nexx/nxencoder-util/stl/nxencoder_idler_housing.stl

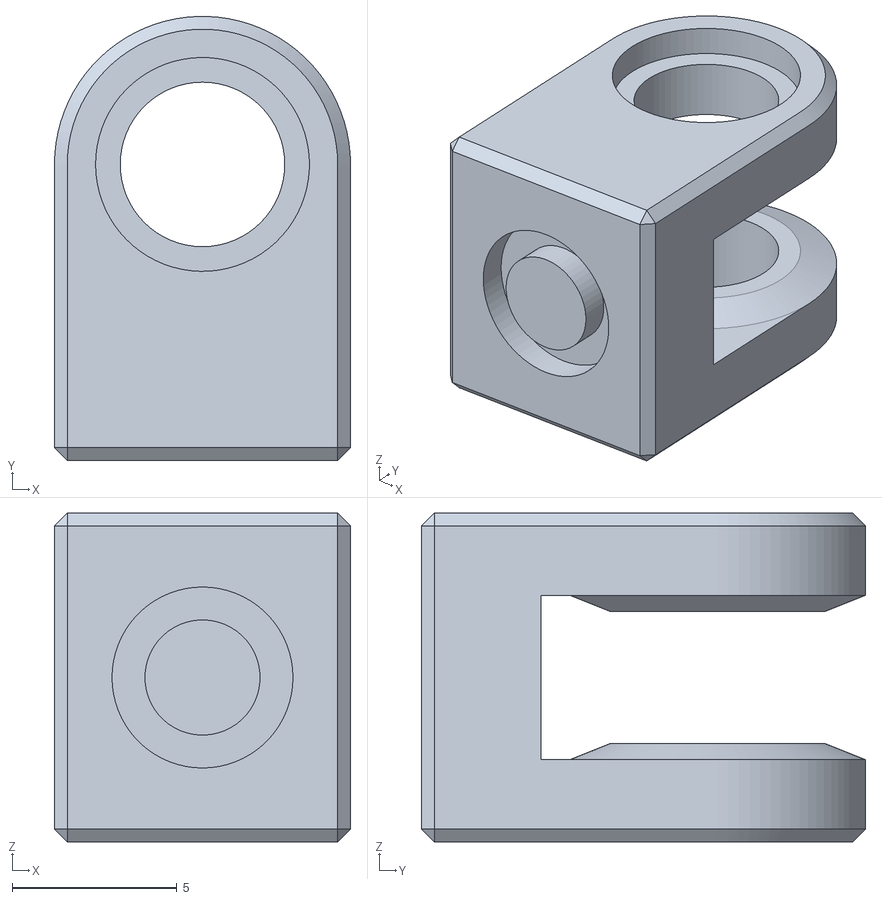
[picture p1: CAD file, 2021-06-08]
stl/nxencoder_idler_housing.stl
9.00 x 13.5 x 10.0
