nexx/nxencoder-util/stl/nxencoder_body_base.stl

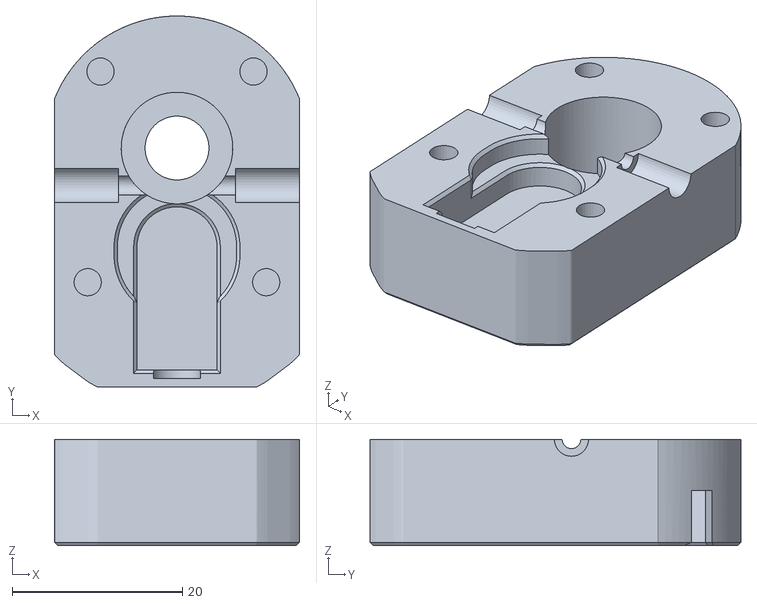
[picture p2: CAD file, 2021-06-08]
stl/nxencoder_body_base.stl
28.8 x 43.5 x 12.5
