nexx/nxencoder-util/stl/nxencoder_body_top.stl

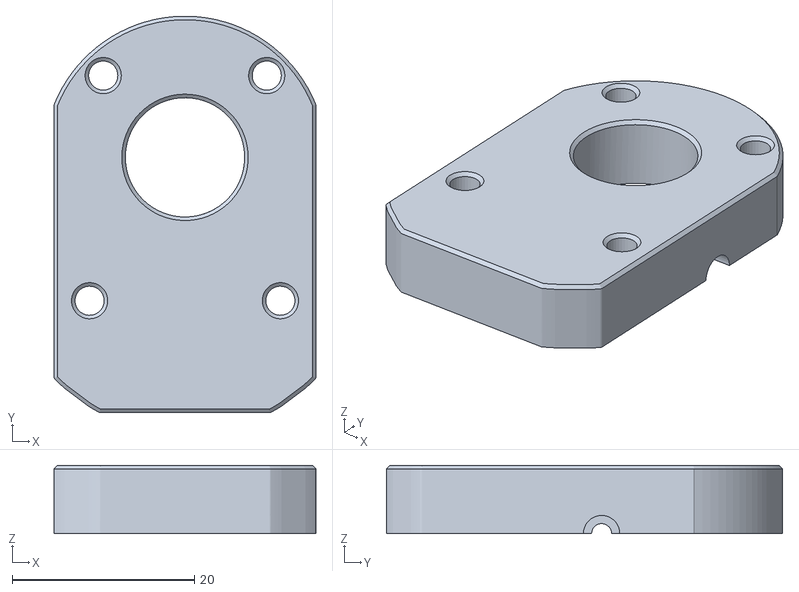
[picture p3: CAD file, 2021-06-08]
stl/nxencoder_body_top.stl
28.8 x 43.5 x 7.50
