nexx/nxencoder-util/stl/nxencoder_idler_pin.stl

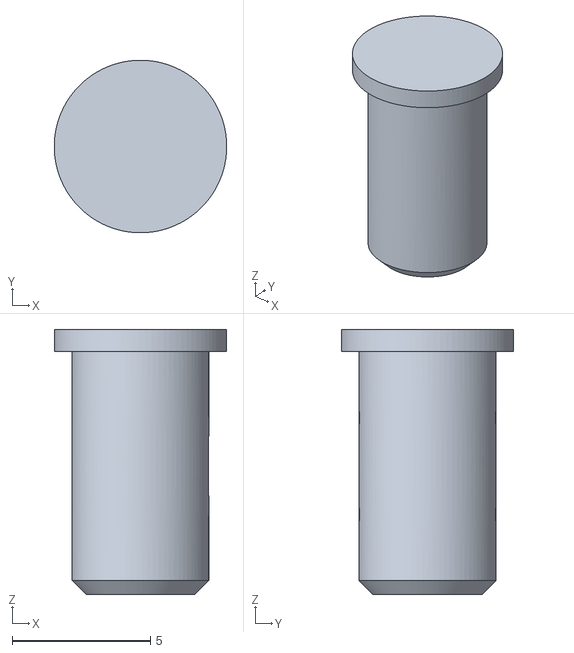
[picture p4: CAD file, 2021-06-08]
stl/nxencoder_idler_pin.stl
6.25 x 6.25 x 9.60
