nexx/nxencoder-util/(commit log)

2021-04-14 Update __main__.py
    - Move to using a pre-compiled ui
    - Implement the QStateMachine for the encoder and printer statuses
    - Implement QSerialPortInfo
    - Implement logging
2021-04-14 Initial serial communication support
    - SerialEncoder class in helpers/serial_encoder.py
    - Add methods for connecting and disconnecting from the encoder.
    - Show firmware details on the GUI
    - Also clean up some code which isn't used yet (more helpers)
2021-04-15 Initial RRF3 Standalone support
    - DuetRRF3 class in helpers/printer_reprapfirmware.py
    - Add methods for connecting and disconnecting from the printer.
    - Show printer details on the GUI
2021-04-15 Error checking for encoder connection
    - Use signals to swap GUI states
    - Check encoder.connect() for success
    - Clear class pointers if connection fails
2021-04-15 Initial multi-threading work
    - Convert DuetRRF3 to QRunnable so it can be spawned as a separate thread.
2021-04-17 Convert serial class to use Qt signals
    - Removed delay during connecting
    - Added new "connecting" state to the state machine
    - Handle the encoder handshake via signal
    - Handle measurements from the encoder via signal
    - Significantly clean up the SerialEncoder class
2021-04-17 Convert DuetRRF3 class to use Qt signals
    - Convert DuetRRF3 from QRunnable to QThread
    - Remove use of QThreadPool in main.py
    - Removes GUI freeze during connecting
    - Handle the printer connection status via signal
    - Handle updates from the printer via signal
    - Significantly clean up the DuetRRF3 class
    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
2021-04-18 Update printer_reprapfirmware.py
    - Add signal for when the tool hits the specified temperature
    - Use M104 to heat the tool, as we wait in the GUI already.
    - Ignore the returned status for send_gcode
    - Shut off all tools when disconnecting
    - Add emergency stop function
2021-04-18 GUI updates & consistency tool
    - Several GUI updates
    - Track the currently selected tool rather than continuously read the combo box
    - Initial handling of data from the serial encoder, dependent on the currently shown tab
    - Population of tool selection on connection to printer
    - Handling of data from printer with GUI updates
    - Introduction of extruder consistency chart & code
2021-04-27 Update printer_reprapfirmware.py
    Significant rewrites of large portions of code:
    - Declare DuetRRF3 as QObject, not QThread
    - Track homed and idle status
    - Resolve hostname to IP, then use that as it makes all requests happen basically instantly
    - Query /rr_status instead of the object model when updating the tracked data. This seems to return faster than /rr_model and I believe places less load on RRF.
    - Use QEventLoop and QTimers instead of sleep()
2021-04-27 Create worker_esteps.py
    This class contains everything required to run the eSteps calibration for the printer.
2021-04-27 Update __main__.py
    - Initial implementation of eSteps calibration
    - Lock the bottom tab frame whilst running any calibration / calculation
    - Clean up of various code sections
2021-04-28 Update esteps calibration
    - Run 10 coarse and 10 fine iterations
    - Calculate the QTimer from distance and feedrate
    - Only show a single live eSteps result, replace the other with the pre-calibration value
    - Track if we are running a worker and make sure certain GUI elements are not re-enabled when we are
    - Allow homing to be skipped if the printer reports all axes are homed
2021-04-29 Disconnect signals on thread.quit()
    This is required as previously a second thread creation would lead to signals being fired multiple times rather than once.
2021-04-29 Logging & error checking overhaul
    - Use signals to log from inside child classes / threads
    - Separate log_event and log_debug, making code tidier
    - Introduce error_critical for showing the user a pop up warning when a critical error occurs
2021-04-30 Initial work on serial printer connections
    - Allow the GUI to swap between a text field and combobox when the printer firmware type is changed.
    - Relabel "Hostname" to "Host or IP"
    - Automatically populate the printer combobox with available serial ports when shown.
2021-05-01 Store and use maximum tool temperature
    - Dynamically update the maximum value of dsbx_tool_temp to match the selected tool max temperature reported by the firmware.
    - Also set a sane maximum default if we didn't retrieve a value from the firmware.
2021-05-01 Fix esteps calibration
    - Correct a couple of silly mistakes.
    - Make sure that esteps_finished is actually called.
2021-05-01 Update esteps calibration
    Improve reporting the results to the GUI by only processing the last result in the list, not the entire list, every time a new result is added.
2021-05-01 Further changes to estep calibration
    - Use the same feedrate for coarse and fine extrusions as it leads to more consistent results
    - Remove the need to reset the encoder per iteration by only using relative measurements
    - Simplify the GUI handling by renaming all the txt_esteps widgets to match, and just have 20 of them
2021-05-02 Initial volumetric calculation work
    Hard coded for 1.75mm filament and a 0.4mm nozzle right now.
2021-05-02 Disable calibration settings during processing
    - Condense all setEnabled calls into a new function named gui_settings_enabled
2021-05-02 Volumetric calculation improvements
    - Now uses a single loop to do all the work
    - Better logging for the user
    - Tweaked cut-off points for under-extrusion
2021-05-04 Add Arduino firmware
    Simplified the firmware as we are only using relative movements, with queried measurements, in the GUI application.
    Also fixed the encoder underflow bug, it now tracks properly when passing below 0.
    [firmware.ino]
2021-05-04 Clean up encoder class for latest firmware
    The newest firmware is simplified and no longer needs a lot of the code previously written.
    - All results returned by the firmware are now relative (removes set_absolute and set_relative).
    - We no longer have automatic reporting of measurements as we request them when needed (removes start, stop and set_interval).
2021-05-05 Initial Klipper (via Moonraker) support
    - Most functions implemented
    - Currently does not emit sig_temp_reached()
    - Does not track homed or idle states
    - Untested on real hardware
2021-05-09 Klipper - Make sure we use relative extrusion
2021-05-09 Klipper - Add function to retrieve step_distance
2021-05-09 Klipper - Fix and enable sig_temp_reached
2021-05-09 Consistency - Slightly increase extruder wait
2021-05-09 GUI - Updates required for Klipper
2021-05-09 Klipper - Fix self.homed and self.idle
2021-05-11 GUI - Remove unused non-linear extrusion
    The GUI changes were committed by mistake.
2021-05-11 GUI - Tweaks for Klipper
2021-05-11 Klipper - Better calculation of extruder parameters
2021-05-11 GUI - Full Klipper support
    - Report rotation_distance instead of steps/mm
    - Report rotation_distance to 6 decimal places
2021-05-11 GUI - Various display tweaks and corrections
    -Display tool temperature with 2 decimal places
    - Display eSteps with 2 decimal places
    - Correct Tool to tool
    - Add event logs for homing and moving tool to the middle
2021-05-11 Klipper - Verify Moonraker rotation_distance vs Klipper
    This fixes a bug where the user has run the esteps calibration, restarted the application but has not updated the Klipper configuration and restarted Klipper. This would otherwise lead to incorrect calculations based on an incorrect rotation_distance.
2021-05-12 Printers - Improve connection logging
2021-05-12 Printers - Only spawn a thread for non-serial printers
2021-05-12 GUI - Add Marlin options
2021-05-12 Marlin - Initial support via serial connection
2021-05-13 Rename move_tomiddle to move_to_safe
    Certain firmware do not allow access to details such as the axes minima and maxima. For those we will just raise the Z from the homing point instead,
2021-05-13 Marlin - Enable homing and moving the tool to a safe location
    Marlin does not let us retrieve the axis maxima at runtime. To move the current tool to a safe position, select and home the tool, then simply raise Z.
2021-05-13 Marlin - Enable setting esteps
    Marlin accepts an M92 command with the tool specified regardless of if DISTINCT_E_FACTORS is enabled or not. Without DISTINCT_E_FACTORS, the command just updates the single esteps value.
2021-05-13 eSteps - Improve logging and also prime nozzle
2021-05-13 Marlin - Use relative extrusion mode
2021-05-13 Marlin - Save esteps to EEPROM automatically
2021-05-13 Volumetric - Tweak distances and tolerances
    Longer extrusions with tighter tolerances leads to more accurate results. This is especially true when the extruder does not skip, but the quality of the extrusion has already suffered greatly.
2021-05-19 GUI - Rename printer firmware options
2021-06-04 Add Klipper config for test-bench
    Used for testing via an in-house test bench only. Not for end-user use.
    [klipper_test_config.cfg]
2021-06-04 Add utility powershell scripts
2021-06-05 README: Update BOM
2021-06-05 Documentation update
    - Corrected error in assembly_instructions
    - Added provisioning_instructions
2021-06-06 README: Update BOM for E3D Hobb Goblin
2021-06-06 DOCS: Update documentation
    Update all documentation for the switch to the E3D Hobb Goblin extruder gear
2021-06-06 FIRMWARE: Update default gear diameter to E3D Hobb Goblin
2021-06-08 STL: v1.1 - Initial release
    [nxencoder_body_base.stl, nxencoder_body_top.stl, nxencoder_idler_housing.stl, nxencoder_idler_pin.stl]
